Alejandro287/Mechatronics_Design/(list of files, cad)

Other CAD files:
Diagrama de control.dwg
Diagrama de fuerza.dwg
Diagrama de disposición de equipo.dwg
Diagrama de la tapa.dwg
OldVersions/Diagrama de la tapa.0002.dwg
OldVersions/Diagrama de disposición de equipo.0002.dwg
OldVersions/Diagrama de fuerza.0001.dwg
OldVersions/Diagrama de control.0001.dwg
0.ipt
0_1.ipt
0_1_1.ipt
0_2.ipt
58511.ipt
ABB MCCB .ipt
DIN 200MM.ipt
DIN 460MM.ipt
Green panel light assembly.iam
OFF.iam
ON.iam
Piezas/65523394-9-abl2rem24150k/OldVersions/abl2rem24150k.0002.iam
Piezas/65523394-9-abl2rem24150k/OldVersions/abl2rem24150k_01.0001.ipt
Piezas/65523394-9-abl2rem24150k/OldVersions/abl2rem24150k_02.0001.ipt
Piezas/65523394-9-abl2rem24150k/OldVersions/abl2rem24150k_03.0003.ipt
Piezas/65523394-9-abl2rem24150k/OldVersions/abl2rem24150k_04.0001.ipt
Piezas/65523394-9-abl2rem24150k/OldVersions/abl2rem24150k_05.0001.ipt
Piezas/65523394-9-abl2rem24150k/OldVersions/abl2rem24150k_06.0001.ipt
Piezas/65523394-9-abl2rem24150k/OldVersions/abl2rem24150k_07.0001.ipt
Piezas/65523394-9-abl2rem24150k/OldVersions/abl2rem24150k_08.0001.ipt
Piezas/65523394-9-abl2rem24150k/OldVersions/abl2rem24150k_09.0001.ipt
Piezas/65523394-9-abl2rem24150k/OldVersions/abl2rem24150k_10.0001.ipt
Piezas/65523394-9-abl2rem24150k/OldVersions/abl2rem24150k_11.0001.ipt
Piezas/65523394-9-abl2rem24150k/OldVersions/abl2rem24150k_12.0001.ipt
Piezas/65523394-9-abl2rem24150k/OldVersions/abl2rem24150k_13.0001.ipt
Piezas/65523394-9-abl2rem24150k/OldVersions/abl2rem24150k_14.0001.ipt
Piezas/65523394-9-abl2rem24150k/OldVersions/abl2rem24150k_15.0001.ipt
Piezas/65523394-9-abl2rem24150k/OldVersions/abl2rem24150k_16.0001.ipt
Piezas/65523394-9-abl2rem24150k/OldVersions/abl2rem24150k_17.0001.ipt
Piezas/65523394-9-abl2rem24150k/OldVersions/abl2rem24150k_18.0001.ipt
Piezas/65523394-9-abl2rem24150k/OldVersions/abl2rem24150k_19.0001.ipt
Piezas/65523394-9-abl2rem24150k/OldVersions/abl2rem24150k_20.0001.ipt
Piezas/65523394-9-abl2rem24150k/OldVersions/abl2rem24150k_21.0001.ipt
Piezas/65523394-9-abl2rem24150k/OldVersions/abl2rem24150k_22.0001.ipt
Piezas/65523394-9-abl2rem24150k/OldVersions/abl2rem24150k_23.0001.ipt
Piezas/65523394-9-abl2rem24150k/OldVersions/abl2rem24150k_24.0001.ipt
Piezas/65523394-9-abl2rem24150k/OldVersions/abl2rem24150k_25.0001.ipt
Piezas/65523394-9-abl2rem24150k/OldVersions/abl2rem24150k_26.0001.ipt
Piezas/65523394-9-abl2rem24150k/OldVersions/abl2rem24150k_27.0001.ipt
Piezas/65523394-9-abl2rem24150k/OldVersions/abl2rem24150k_28.0001.ipt
Piezas/65523394-9-abl2rem24150k/OldVersions/abl2rem24150k_29.0001.ipt
Piezas/65523394-9-abl2rem24150k/OldVersions/abl2rem24150k_30.0001.ipt
Piezas/65523394-9-abl2rem24150k/OldVersions/abl2rem24150k_31.0001.ipt
Piezas/65523394-9-abl2rem24150k/OldVersions/abl2rem24150k_32.0001.ipt
Piezas/65523394-9-abl2rem24150k/OldVersions/abl2rem24150k_33.0001.ipt
Piezas/65523394-9-abl2rem24150k/OldVersions/abl2rem24150k_34.0001.ipt
Piezas/65523394-9-abl2rem24150k/OldVersions/abl2rem24150k_35.0001.ipt
Piezas/65523394-9-abl2rem24150k/OldVersions/abl2rem24150k_36.0001.ipt
Piezas/65523394-9-abl2rem24150k/OldVersions/abl2rem24150k_37.0001.ipt
Piezas/65523394-9-abl2rem24150k/OldVersions/abl2rem24150k_38.0001.ipt
Piezas/65523394-9-abl2rem24150k/OldVersions/abl2rem24150k_39.0001.ipt
Piezas/65523394-9-abl2rem24150k/OldVersions/abl2rem24150k_40.0001.ipt
Piezas/65523394-9-abl2rem24150k/OldVersions/abl2rem24150k_41.0001.ipt
Piezas/65523394-9-abl2rem24150k/OldVersions/abl2rem24150k_42.0001.ipt
Piezas/65523394-9-abl2rem24150k/OldVersions/abl2rem24150k_43.0001.ipt
Piezas/65523394-9-abl2rem24150k/OldVersions/abl2rem24150k_44.0001.ipt
Piezas/65523394-9-abl2rem24150k/OldVersions/abl2rem24150k_45.0001.ipt
Piezas/65523394-9-abl2rem24150k/OldVersions/abl2rem24150k_46.0001.ipt
Piezas/65523394-9-abl2rem24150k/OldVersions/abl2rem24150k_47.0001.ipt
Piezas/65523394-9-abl2rem24150k/OldVersions/abl2rem24150k_48.0001.ipt
Piezas/65523394-9-abl2rem24150k/OldVersions/abl2rem24150k_49.0001.ipt
Piezas/65523394-9-abl2rem24150k/OldVersions/abl2rem24150k_50.0001.ipt
Piezas/65523394-9-abl2rem24150k/OldVersions/abl2rem24150k_51.0001.ipt
Piezas/65523394-9-abl2rem24150k/OldVersions/abl2rem24150k_52.0001.ipt
Piezas/65523394-9-abl2rem24150k/OldVersions/abl2rem24150k_53.0001.ipt
Piezas/65523394-9-abl2rem24150k/abl2rem24150k.iam
Piezas/65523394-9-abl2rem24150k/abl2rem24150k_01.ipt
Piezas/65523394-9-abl2rem24150k/abl2rem24150k_02.ipt
Piezas/65523394-9-abl2rem24150k/abl2rem24150k_03.ipt
Piezas/65523394-9-abl2rem24150k/abl2rem24150k_04.ipt
Piezas/65523394-9-abl2rem24150k/abl2rem24150k_05.ipt
Piezas/65523394-9-abl2rem24150k/abl2rem24150k_06.ipt
Piezas/65523394-9-abl2rem24150k/abl2rem24150k_07.ipt
Piezas/65523394-9-abl2rem24150k/abl2rem24150k_08.ipt
Piezas/65523394-9-abl2rem24150k/abl2rem24150k_09.ipt
Piezas/65523394-9-abl2rem24150k/abl2rem24150k_10.ipt
Piezas/65523394-9-abl2rem24150k/abl2rem24150k_11.ipt
Piezas/65523394-9-abl2rem24150k/abl2rem24150k_12.ipt
Piezas/65523394-9-abl2rem24150k/abl2rem24150k_13.ipt
Piezas/65523394-9-abl2rem24150k/abl2rem24150k_14.ipt
Piezas/65523394-9-abl2rem24150k/abl2rem24150k_15.ipt
Piezas/65523394-9-abl2rem24150k/abl2rem24150k_16.ipt
Piezas/65523394-9-abl2rem24150k/abl2rem24150k_17.ipt
Piezas/65523394-9-abl2rem24150k/abl2rem24150k_18.ipt
Piezas/65523394-9-abl2rem24150k/abl2rem24150k_19.ipt
Piezas/65523394-9-abl2rem24150k/abl2rem24150k_20.ipt
Piezas/65523394-9-abl2rem24150k/abl2rem24150k_21.ipt
Piezas/65523394-9-abl2rem24150k/abl2rem24150k_22.ipt
Piezas/65523394-9-abl2rem24150k/abl2rem24150k_23.ipt
Piezas/65523394-9-abl2rem24150k/abl2rem24150k_24.ipt
Piezas/65523394-9-abl2rem24150k/abl2rem24150k_25.ipt
Piezas/65523394-9-abl2rem24150k/abl2rem24150k_26.ipt
Piezas/65523394-9-abl2rem24150k/abl2rem24150k_27.ipt
Piezas/65523394-9-abl2rem24150k/abl2rem24150k_28.ipt
Piezas/65523394-9-abl2rem24150k/abl2rem24150k_29.ipt
Piezas/65523394-9-abl2rem24150k/abl2rem24150k_30.ipt
Piezas/65523394-9-abl2rem24150k/abl2rem24150k_31.ipt
Piezas/65523394-9-abl2rem24150k/abl2rem24150k_32.ipt
Piezas/65523394-9-abl2rem24150k/abl2rem24150k_33.ipt
Piezas/65523394-9-abl2rem24150k/abl2rem24150k_34.ipt
Piezas/65523394-9-abl2rem24150k/abl2rem24150k_35.ipt
Piezas/65523394-9-abl2rem24150k/abl2rem24150k_36.ipt
Piezas/65523394-9-abl2rem24150k/abl2rem24150k_37.ipt
Piezas/65523394-9-abl2rem24150k/abl2rem24150k_38.ipt
Piezas/65523394-9-abl2rem24150k/abl2rem24150k_39.ipt
Piezas/65523394-9-abl2rem24150k/abl2rem24150k_40.ipt
Piezas/65523394-9-abl2rem24150k/abl2rem24150k_41.ipt
Piezas/65523394-9-abl2rem24150k/abl2rem24150k_42.ipt
Piezas/65523394-9-abl2rem24150k/abl2rem24150k_43.ipt
Piezas/65523394-9-abl2rem24150k/abl2rem24150k_44.ipt
Piezas/65523394-9-abl2rem24150k/abl2rem24150k_45.ipt
Piezas/65523394-9-abl2rem24150k/abl2rem24150k_46.ipt
Piezas/65523394-9-abl2rem24150k/abl2rem24150k_47.ipt
Piezas/65523394-9-abl2rem24150k/abl2rem24150k_48.ipt
Piezas/65523394-9-abl2rem24150k/abl2rem24150k_49.ipt
Piezas/65523394-9-abl2rem24150k/abl2rem24150k_50.ipt
Piezas/65523394-9-abl2rem24150k/abl2rem24150k_51.ipt
Piezas/65523394-9-abl2rem24150k/abl2rem24150k_52.ipt
Piezas/65523394-9-abl2rem24150k/abl2rem24150k_53.ipt
Piezas/65523877-9-programmable_controller_twdlcda10drf/OldVersions/programmable_controller_twdlcda10drf.0003.ipt
Piezas/65523877-9-programmable_controller_twdlcda10drf/programmable_controller_twdlcda10drf.ipt
Piezas/65524194-9-lxm28au20m3x/lxm28au20m3x.iam
Piezas/65524194-9-lxm28au20m3x/lxm28au20m3x_01.ipt
Piezas/65524194-9-lxm28au20m3x/lxm28au20m3x_02.ipt
Piezas/65533159-9-bch2mm1521ca6c/bch2mm1521ca6c.ipt
Piezas/65533260-9-lxm28au15m3x/OldVersions/lxm28au15m3x.0002.iam
Piezas/65533260-9-lxm28au15m3x/OldVersions/lxm28au15m3x_01.0002.ipt
Piezas/65533260-9-lxm28au15m3x/OldVersions/lxm28au15m3x_02.0001.ipt
Piezas/65533260-9-lxm28au15m3x/OldVersions/lxm28au15m3x_03.0001.ipt
Piezas/65533260-9-lxm28au15m3x/OldVersions/lxm28au15m3x_04.0001.ipt
Piezas/65533260-9-lxm28au15m3x/OldVersions/lxm28au15m3x_05.0001.ipt
Piezas/65533260-9-lxm28au15m3x/OldVersions/lxm28au15m3x_06.0001.ipt
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
